bfoz/zenith_ch750sd/README.md

# Zenith CH750 Super Duty

Custom sheet-metal parts and brackets that can be used to improve wire, cable, and hose routing and to mount accessories.

## Fabrication

The various online cut shops have different ordering processes so you'll need to consult their documentation. 

If you're familiar with FreeCAD's Sheet Metal Workbench you can try using the "Unfold" feature to generate the flattened drawing files to send to the shop. 
However, exporting to a STEP file seems to produce more consistent results.

NOTE: As of June 2025, the unfolded files don't work well with [Send Cut Send](https://sendcutsend.com); use the STEP files instead.

### Regenerating the STEP files

The STEP files for every part are generated from the FreeCAD documents, so they always match the current models. If you change a model and want updated fabrication files, or you've cloned the repository and want to build them yourself:

1. Install [FreeCAD](https://www.freecad.org) 1.1 or later
2. Run `make` in the repository root

The build reads `scripts/parts.manifest`, which lists one line per output file:

    <FreeCAD document> | <body label> | <output filename>

Everything is written into the `step` directory at the repository root, and every filename there is unique. `make clean` removes the directory; `make clean-steps` removes just the declared files.

Only parts that are missing or older than their source document get rebuilt. `make check` re-exports everything and verifies each file, `make list` shows what would be built, and `make help` lists the rest. It's also fine to skip `make` and export the parts by hand in the FreeCAD GUI — just keep the filenames matching the manifest.

If you'd rather not install FreeCAD at all, the GitHub Actions workflow regenerates every STEP file on each change and attaches them to the run as a downloadable artifact. Open the workflow run, then download `zenith-ch750sd-step-files-...` from the Artifacts list at the bottom of the summary page. Each release carries two zips named `<repo>-<tag>-<contents>.zip`: the `-STEP.zip` holds the fabricated parts for a cut shop, and the `-FreeCAD.zip` holds the source documents.

## ACK E04 ELT Bracket

`ACK_E04_ELT_Bracket`

If you mount your ELT in the aft section, next to the access hole, this bracket will mount the ELT "within 10 degrees of the airplane's longitudinal axis", as required by the installation instructions.

### Fabrication

The CAD file includes two parts: `ACK_E04_ELT_Bracket` and `ACK_E04_ELT`. Only fabricate the bracket. The other part is for reference.

- Send `ACK_E04_ELT_Bracket-ACK_E04_ELT_Bracket.step` to your favorite cut shop (see [Regenerating the STEP files](#regenerating-the-step-files) if you changed the model)
- Use 1mm thick (0.040") Aluminum
- The CAD file uses the bend radius and K-factor for [Send Cut Send](https://sendcutsend.com) (0.024" and 0.45). Adjust as needed for your shop.

### Installation

The bracket can be used anywhere on the aft sloped skin that it fits. Mount it with the taller end pointing forward.

The rivet hole patten on the flanges is meant to line up with the rivet holes in the Z-angle (SD75F19-1) along the port edge of the rear access hole. You'll need to match drill holes in the bottom skin for the other side of the bracket. If you've already riveted the Z-angle, then you'll need to drill out some of those rivets too.

Alternatively, you can slide the bracket forward until it fits entirely on the skin, and then match drill all of the rivet holes. Note that if you move it too far forward you'll lose access to the front end of the ELT (where the wires and buttons are).

**NOTE:** Fasten the ELT mounting bands to the top of the bracket before riveting the bracket to the airframe. Otherwise, you'll have difficulty tightening the nuts.

## Wing Trailing Edge Bracket

The stock kit doesn't use the space inside of the wing trailing edge skins for very much.
If your build uses that space for a fuel return hose, or for the pitot and AoA hoses, you can use these brackets to help keep everything organized.

The file `TrailingEdgeBracket.FCStd` is a FreeCAD file containing several different bracket designs meant for different configurations of wiring and hoses in the left wing. 

The part named `OutboardTrailingEdgeBracket` is intended to hold the wires that go out to the wingtips and the slats (if you have those). 
You can either use 4 of these brackets for each wing and replace the ziptie anchors that came in the kit, or you can use one for each wing just inboard of the joiner bracket in the rear spar.
If you have a fuel return hose from your engine (ULPower etc), you'll want to use at least one of these (inboard of the joiner plate but outboard of the fuel hose) to help hold the wires off of that hose.

For the right wing, which doesn't have Pitot or AoA tubes, you can use `OutboardTrailingEdgeBracket` for the inboard brackets as well. 

To make the brackets for the right wing, you'll need to flip the bend angle for half of the parts. 
Alternatively, most cut shops that do online ordering will give you the option of duplicating the part with a reversed bend angle at order time.
You'll have two extra holes in the resulting right wing bracket because only the left wing has the pitot and AoA tubes. Feel free to use those holes for something else, or simply leave them unpopulated.

If you're using the braided fuel hoses from [Aircraft Specialty](https://www.aircraftspecialty.com) the part named `BushingsGrommets` should work well for you.

### Bushings and Grommets

Each bracket is meant to be used with snap bushings and grommets for holding the hoses and wires. 

These parts have been used successfully with fuel hoses from [Aircraft Specialty](https://www.aircraftspecialty.com) and the [Dynon pneumatic installation kit](https://shop.dynon.com/products/pitot-static-aoa-pneumatic-installation-kit):

- [1/4" ID Snap Bushings](https://www.amazon.com/dp/B00OP6070I) for 1/4" OD pitot and AoA hoses
- [1/2" ID AN931 Elastic Grommet](https://www.aircraftspruce.com/catalog/appages/an931.php) for the fuel return hose
- [1/4" ID AN931 Elastic Grommet](https://www.aircraftspruce.com/catalog/appages/an931.php) for the wingtip and landing light wires

If you're planning to use `OutboardTrailingEdgeBracket` outboard of the fuel hoses you'll likely need some 1/8" ID grommets for the wires. Either of these will fit:

- [1/8" ID Oil Resistant Buna-O Rubber Grommets](https://www.mcmaster.com/9307K35/)
- [1/8" ID High Temperature Silicone Rubber](https://www.mcmaster.com/1061T11/)

**NOTE:** The part named `OutboardTrailingEdgeBracketTape` is meant to be used with double sided tape. Be sure to get a strong tape that can handle extreme conditions. I used 3M VHB tape.

### Installation

1. Slide the brackets and grommets onto the fuel return hose first. You won't be able to that later.
2. The fuel return hoses grommets are a tight fit. Use a small flat screwdriver to force the grommets into the bracket around the hose. Be careful to not damage the grommets.
3. Push the 1/4" ID wire grommets into their respective holes
4. Snap the snap bushings into their holes
5. Cleco the brackets to the rear spar
6. Feed the pitot and AoA tubes through the snap bushings
7. Feed the wires through the wire grommets
8. Rivet the brackets once you're happy with everything

## Fuel Return Hose Bracket

`FuelReturnHoseBracket.FCStd`

If you're using a fuel return hose and routing it through the wing bay just outboard of the fuel tank, 
this bracket can be used to keep the hose from bouncing around inside of the wing.

The part in the file is for the left wing. Flip the bend angle to make the part for the right wing.

### Bushings and Grommets

- [1/2" ID AN931 Elastic Grommet](https://www.aircraftspruce.com/catalog/appages/an931.php) 

### Installation

- Use 2 A4 rivets to attach the bracket to the rear stiffener in the wing bay just outboard of the fuel tank. You will need to match drill holes in the stiffener.
- Position the bracket roughly in the middle of the stiffener, or wherever seems to be right for your fuel hose.
- The stiffening flange of the bracket should be outboard of the fuel hose to prevent the hose from rubbing on the flange. 

## Wingtip wire brackets

`WingtipWireBracket.FCStd`

If you run the wingtip wires through the outboard-most bay in the wing, this bracket will keep the wires from flopping around inside that bay.

**NOTE**: This bracket is currently sized for the 3-conductor wire that comes with the kit. I haven't yet tested it with the 4-conductor wire that most builders use.

### Bushings and Grommets

- [1/8" ID AN931 Elastic Grommet](https://www.aircraftspruce.com/catalog/appages/an931.php) 

### Installation

1. Align the bracket with the stiffener in the outobard-most bay of the wing
2. Match-drill the two rivet holes using a #30 drill bit
3. Rivet to the stiffener with 2 A4 rivets
4. Push the grommet into the hole
5. Feed the wires through the grommet

## Elevator Pulley Bracket

`ElevatorPulleyBracket.FCStd`

The stock kit uses nylon blocks as "pulleys" for the elevator control cables. Presumably, steel cables rubbing on plastic will eventually wear out the plastic, 
necessitating periodic replacement. If you'd like to avoid that problem, or at least delay it, you can install pulleys just forward of the jump seat rear channel 
that will keep the control cables from rubbing on the nylon.

### Fabrication

The CAD file includes two parts, `Bracket` and `Base`, that need to be fabricated. The other parts are only for reference. 

- Send `ElevatorPulleyBracket-Bracket.step` and `ElevatorPulleyBracket-Base.step` to your favorite cut shop (see [Regenerating the STEP files](#regenerating-the-step-files) if you changed the model)
- Use 1mm thick (0.040") Aluminum for both parts
- The CAD file uses the bend radius and K-factor for [Send Cut Send](https://sendcutsend.com). Adjust as needed for your shop.

### Parts

| Part Number | Quantity | Description |
|---|---|---|
| [MC20220-1](https://www.aircraftspruce.com/catalog/pnpages/MS20220-1.php) | 2 | 1.75" Phenolic Pulley |
| [AN5-13A](https://www.aircraftspruce.com/catalog/hapages/an5.php) | 2 | Bolt |
| [AN365-524A](https://www.aircraftspruce.com/pages/ha/nut_an365/an365_2.php) | 2 | Elastic Stop Nut |
| [AN960-516](https://www.aircraftspruce.com/catalog/hapages/flatwashers.php) | 4 | Washer |
| | | Tape (blue tape, electrical tape, whatever is handy)  |

### Installation

**NOTE**: The base plates can be installed on either the inside, or the outside, of the airplane. The cables will line up either way. The difference is purely aesthetic.

1. Run the control cables through the holes in the rear jump seat channel, tie weights to the ends, and adjust to approximate the final position of the cables
2. Set the base plate and pulley brackets on the cabin floor with the cables running through the brackets
3. Install the pulleys in the brackets (using the bolts, nuts, and washers) with the cables under the pulleys
4. Align the pulleys and brackets with the cables and make sure everything looks "right"
5. With the base plates under the brackets, and all of the rivet holes aligned, tape the base plates to the cabin floor skin
6. Remove the pulleys and brackets while leaving the base plate in place
7. Match drill the holes in the base plates through the cabin floor skin using a #20 drill bit
8. Debur the holes
9. Cleco the base plates and brackets in place. **NOTE**: The base plates can be installed on the inside or the outside of the airplane. The choice is purely aesthetic.
10. Rivet with A5 rivets **from the outisde** of the airplane
11. Re-install the pulleys with the control cables under the pulleys

## Matco Parking Brake Valve Bracket

`MatcoParkingBrakeBracket.FCStd`

The brake line kit from [Aircraft Specialty](https://www.aircraftspecialty.com/Superdutybrakes.html) doesn't come with any brackets for mounting the [Matco parking brake valve](https://matcoals.com/product/parking-brake-valve-dual/). 
The included hoses are cut to length assuming that you have the brackets that you can see in [Mark Pensenstadler's video](https://youtu.be/gur6rt8JNb0?si=d8QNzfhoa7Ir_gkw) 
(the kit was created to fit his airplane). Unfortunately, Mark made his brackets out of scrap aluminum and he didn't provide enough details 
to make your own, nor did he say anything about selling the brackets himself.

The brackets in this file are my attempt to replicate Mark's design. Although, I made the top piece overlap the bottom pieces because I think it looks better that way.
It will still work if you prefer it the other way.

I also switched the bottom mounting holes from A4 rivets to M4 bolts. Drilling rivet holes in the heel support plate traps shavings in a way that's very hard to clean out. 
It would be better to drill the holes before riveting the support plate, but that isn't always possible, or obvious ahead of time. 
Using M4 adhesive mounting studs is a much cleaner, and more expensive, option.

The CAD file also includes models of the four adhesive studs positioned in the assembly, so you can check fitment before ordering. They are reference geometry only — nothing in the model gets cut, and they are not part of the STEP exports. As modelled, two pairs of adjacent stud bases overlap each other and one stud clips the edge of the bottom bracket, which is the clearance problem called out in the installation steps below.

### Parts

| Part Number | Quantity  | Product Page | Description |
|---|---|---|---|
| Zenith Super Duty Brake kit | 1 | [Link](https://www.aircraftspecialty.com/Superdutybrakes.html) | Aircraft Specialty Zenith Super Duty Brake kit |
| 97590A711 | 4 | [McMaster-Carr](https://www.mcmaster.com/products/adhesive-mount-studs/thread-size~m4-1/) | Adhesive-Ready Studs, Zinc-Plated Steel, M4x 0.7mm Thread, 10mm Long, 23mm Diameter Base  |
| M4 Elastic Locking Nuts | 4 | | |
| Adhesive | | | JB Weld, Gorilla Expoxy, Scotch-Weld DP100FR, etc |

### Installation

1. Using A4 rivets, rivet the top piece to the bottom pieces to make it look like the assembly in the CAD file
2. The bases of the mounting studs will overlap. You'll need to trim about 5mm off one side of each. Test fit in the brackets to ensure clearance.
3. Clean the mounting area on the heel plate thoroughly to remove all dust, grease, oil, etc
3. Bolt the valve to the top plate. Make sure to install the bolt from the bottom. When the valve is installed, you should have the nuts and rubber washers on top.
4. Make sure the shiny end of the brake valve is pointing aft
5. Bolt the studs into the bottom of the bracket and tighten
6. Apply adhesive to the mounting side of each stud
7. **NOTE: This step is permanent!** Locate the bracket where you want it to be on the heel plate and press the studs onto the metal. **NOTE: This is permanent!**
8. Follow the adhesive manufacturer's instructions for set time, clamping pressure, etc

## Rudder Pedal Brackets

`RudderPedalBracketAssembly.FCStd`

The provided brackets are also used as bearings for the rudder pedals, but it's just a bare metal-on-metal surface. 
Because the pedals are steel, most builders either paint or powder coat them. Over time, the coating wears off and stops protecting the steel.
These brackets replace the aluminum brackets that came in your kit, and add a Delrin bushing to act as a bearing. 
The brackets' holes for the tubes have also been enlarged to avoid wearing on the tubes. 
The Delrin holes should be a snug fit for a powder coated pedal tube, and might be a little loose for a painted tube. Feel free to adjust the hole size if needed.

### Additional Parts

| Part Number | Quantity | Description |
|---|---|---|
| M5x16 Socket Head Screw  | 4 | Standard thread metric bolts. Other head shapes are acceptable. |
| M5 Washer | 8 | Washers for M5 bolts |
| M5 Lock Nut | 4 | Locking nuts for M5 bolts |

### Installation

1. Using the kit-provided hardware, bolt each bracket to the cabin floor skins in the normal fashion. *NOTE* The upper bolts interfere with installing the lower bolts.
2. Using the metric hardware, bolt the Delrin pieces to the inboard side of each bracket. Use washers under the heads and the nuts
3. Slide the rudder tubes into the brackets from the inboard side
