bfoz/zenith_ch750sd/MatcoParkingBrakeBracket.FCStd

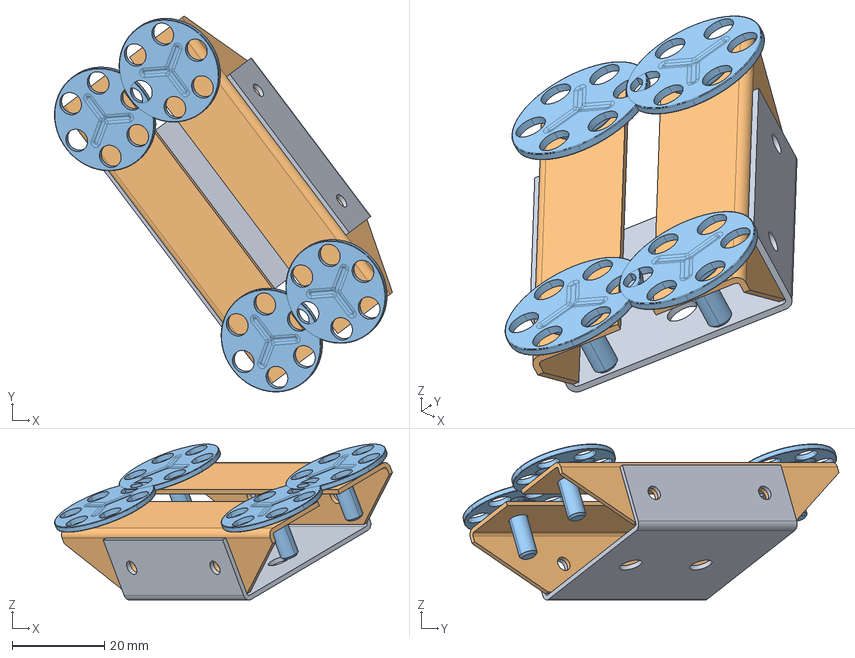
[picture p1: CAD file, 2026-10-24]
MatcoParkingBrakeBracket.FCStd
73.2 x 81.5 x 33.8 mm
Top Bracket
Bottom Bracket x 2
97590A711_NO THREADS_Adhesive-Ready Studs x 4
